BRYANSFM/Bryan_Fernandez_ELECTIVA_2025_C2/Fuentes de Informacion  para la placa.pdf

Paginas en donde indague sobre:
Esquemas electrónicos de las funcionalidades que necesitamos (RS-485 - Entradas digitales NPN PNP - Salidas y entradas 0-10 - salidas y entradas 4-20ma). https://www.wut.de/e-6wwww-11-apes-000.phphttps://www.sinsmarts.com/es/blog/rs232-or-rs485-comparing-the-key-differences/https://maplesystems.com/faq/what-is-the-dif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 (https://www.reddit.com/r/PLC/comments/71lqb3/i_understand_the_difference_between_pnp_and_npn/)
https://www.balluff.com/en-us/blog/analog-signals-0-to-10-v-vs-4-to-20-ma
