BRYANSFM/Bryan_Fernandez_ELECTIVA_2025_C2/Garabato, PCB.pdf

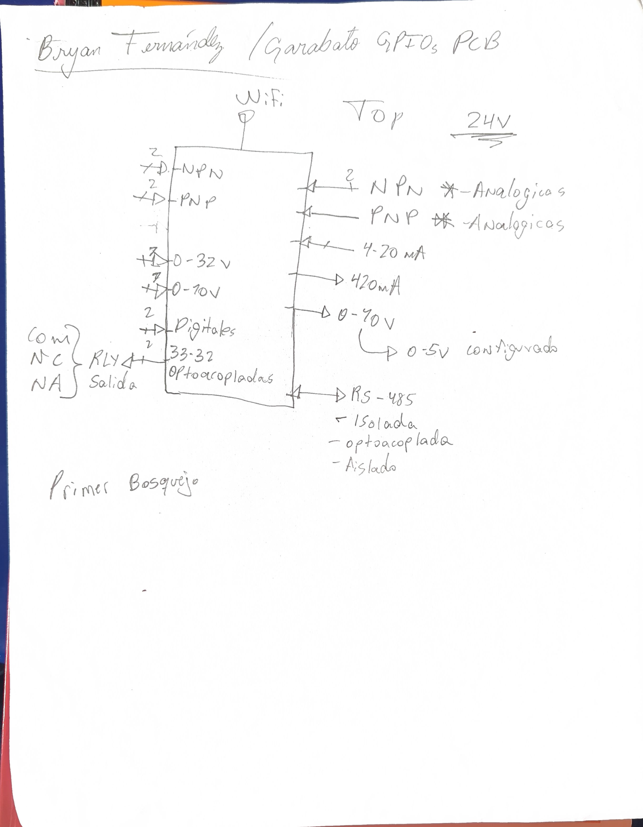
[picture p1: page 1]
