BRYANSFM/Bryan_Fernandez_ELECTIVA_2025_C2/Caja_para_PCB(FreeCAD)/Caja_para_PCB(FreeCAD)/Caja_Parte_de_Arriba_Electiva.FCStd

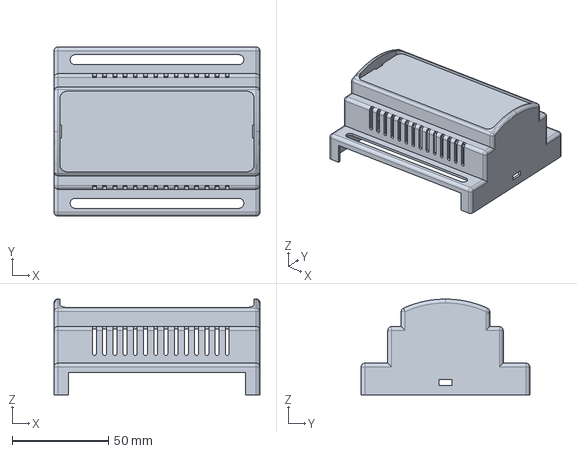
[picture p2: CAD file, 2025-07-17]
Caja_para_PCB(FreeCAD)/Caja_para_PCB(FreeCAD)/Caja_Parte_de_Arriba_Electiva.FCStd
107.0 x 87.7 x 49.8 mm
