BRYANSFM/Bryan_Fernandez_ELECTIVA_2025_C2/Huella YLPTEC RSM3485ECHT C2992406.DXF

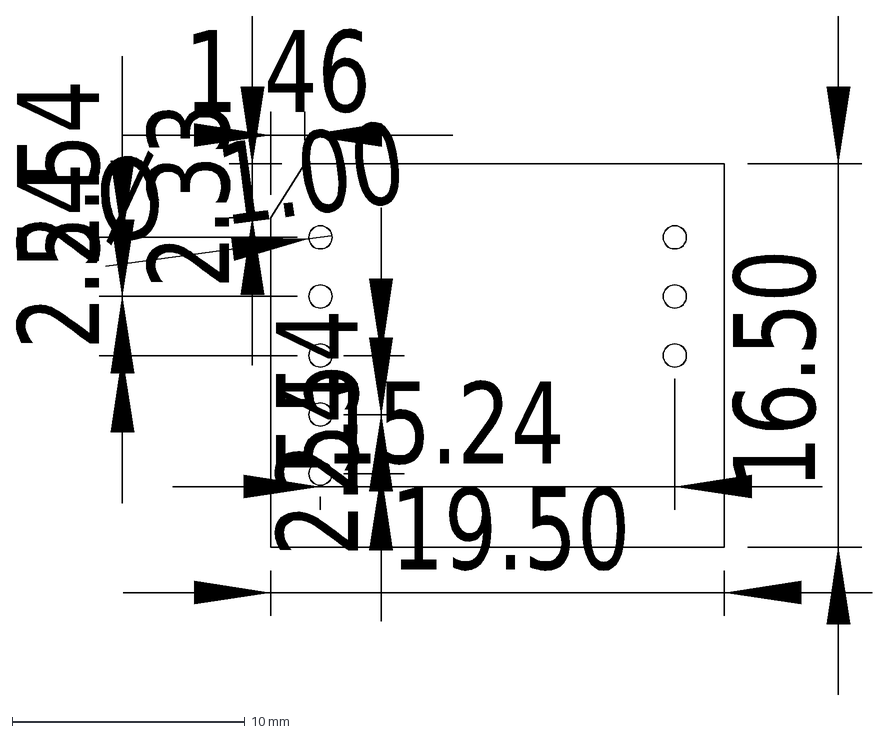
[picture p3: CAD file, 2025-07-16]
Huella YLPTEC RSM3485ECHT C2992406.DXF
16.50
15.24
2.54
Ø
1.00
19.50
1.46
2.33
