BRYANSFM/Bryan_Fernandez_ELECTIVA_2025_C2/Caja_para_PCB(FreeCAD)/Caja_para_PCB(FreeCAD)/Caja_Electiva.FCStd

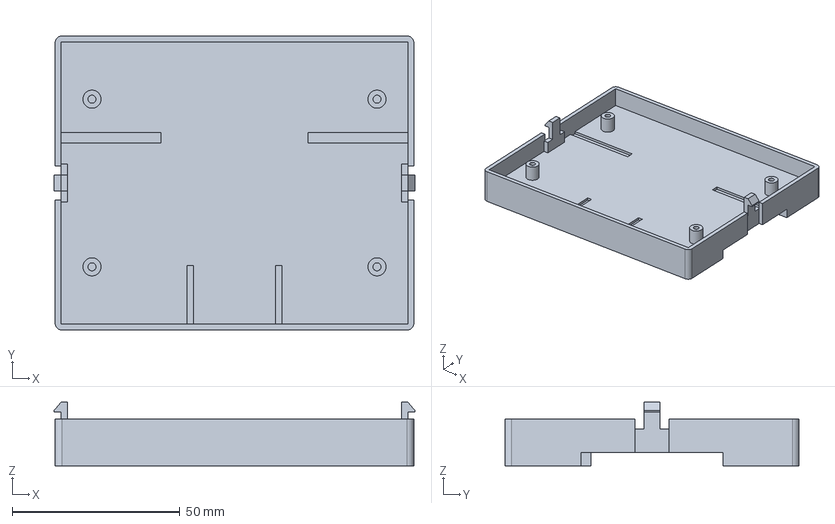
[picture p4: CAD file, 2025-07-11]
Caja_para_PCB(FreeCAD)/Caja_para_PCB(FreeCAD)/Caja_Electiva.FCStd
107.7 x 87.7 x 19.0 mm
