BRYANSFM/Bryan_Fernandez_ELECTIVA_2025_C2/Caja_Parte_de_Arriba_Electiva.dxf

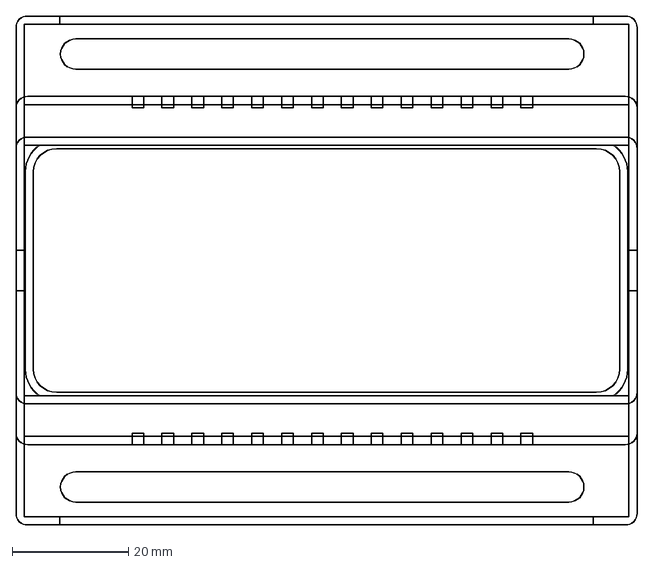
[picture p5: CAD file, 2025-07-11]
Caja_Parte_de_Arriba_Electiva.dxf
107.0 x 87.7 mm
