BRYANSFM/Bryan_Fernandez_ELECTIVA_2025_C2/CajaElectiva_para_PCB.dxf

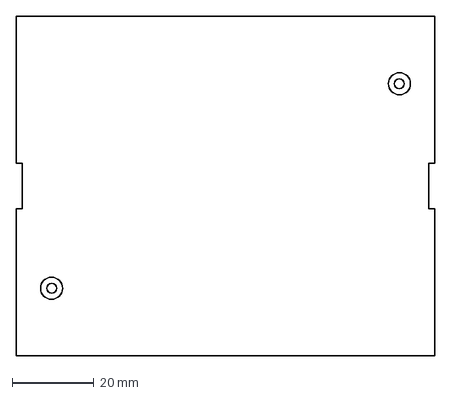
[picture p6: CAD file, 2025-07-11]
CajaElectiva_para_PCB.dxf
102.2 x 83.0 mm
