BRYANSFM/Bryan_Fernandez_ELECTIVA_2025_C2/zorionx_nivara/zorionx_nivara.kicad_pcb

## KiCad design zorionx_nivara/zorionx_nivara.kicad_pcb (2025-08-22)

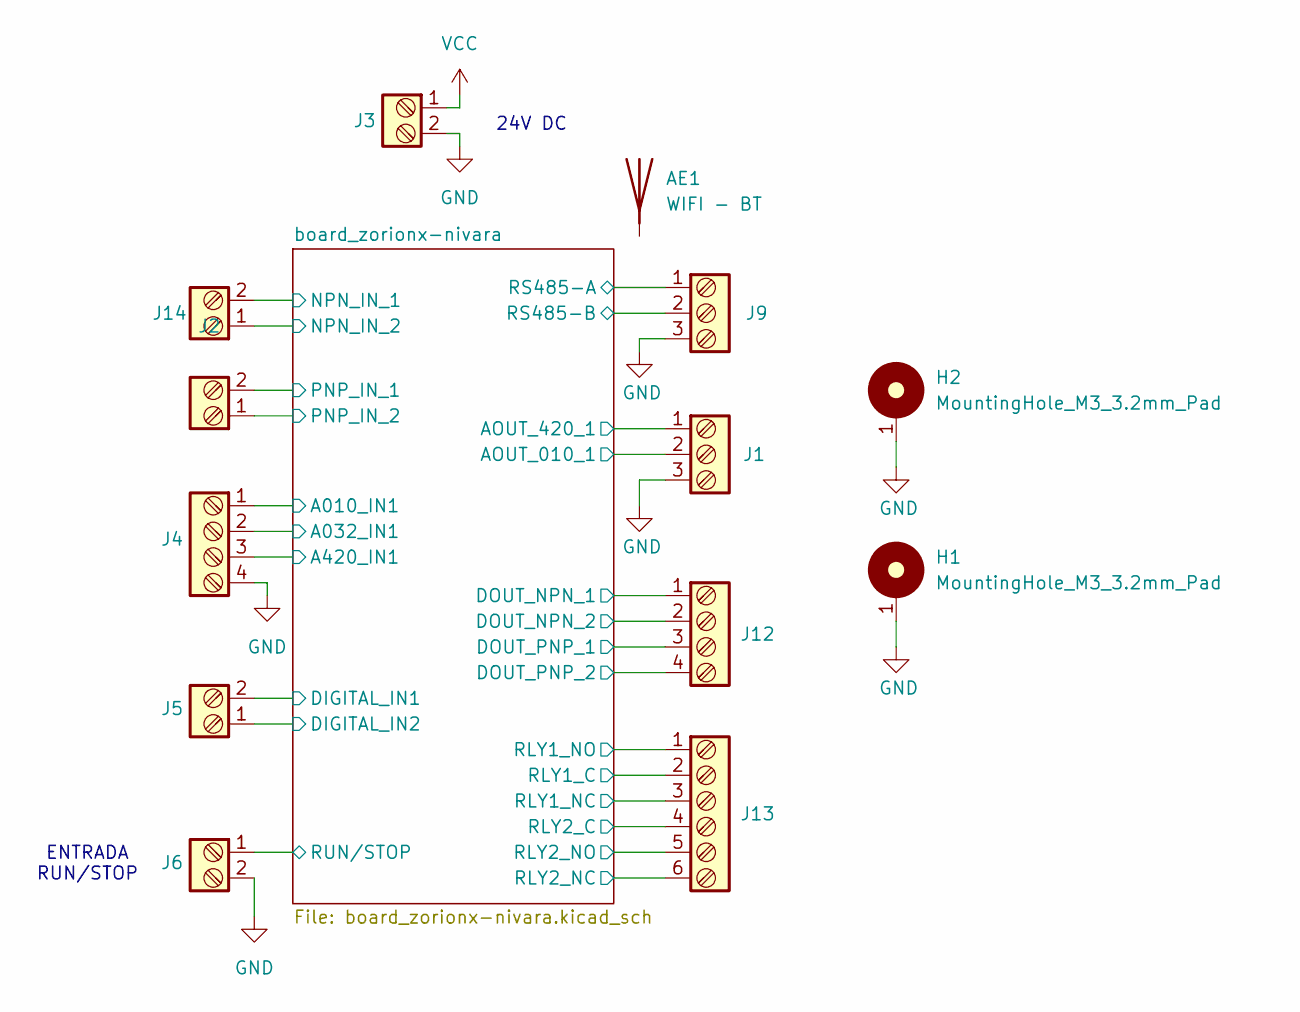
[picture p7: schematic zorionx_nivara.kicad_sch, ZorionX - Nivara / Bryan S. Fernandez M. 2022-0917]

Parts:
AE1: WIFI - BT
H1, H2: MountingHole_M3_3.2mm_Pad; MountingHole_3.2mm_Pad
J1: Salidas Analogicas; TerminalBlock_Phoenix_PT-1,5-3-5.0-H_1x03_P5.00mm_Horizontal
J2: Entrada PNP; TerminalBlock_Phoenix_PT-1,5-2-5.0-H_1x02_P5.00mm_Horizontal
J3: Alimentacion; TerminalBlock_Phoenix_PT-1,5-2-5.0-H_1x02_P5.00mm_Horizontal
J4: Entradas Analogicas; TerminalBlock_Phoenix_PT-1,5-4-5.0-H_1x04_P5.00mm_Horizontal
J5: Entradas digitales; TerminalBlock_Phoenix_PT-1,5-2-5.0-H_1x02_P5.00mm_Horizontal
J6: RUN/STOP; TerminalBlock_Phoenix_PT-1,5-2-5.0-H_1x02_P5.00mm_Horizontal
J9: RS-485; TerminalBlock_Phoenix_PT-1,5-3-5.0-H_1x03_P5.00mm_Horizontal
J12: Salidas NPN/PNP; TerminalBlock_Phoenix_PT-1,5-4-5.0-H_1x04_P5.00mm_Horizontal
J13: Reles; TerminalBlock_Phoenix_PT-1,5-6-5.0-H_1x06_P5.00mm_Horizontal
J14: Entrada NPN; TerminalBlock_Phoenix_PT-1,5-2-5.0-H_1x02_P5.00mm_Horizontal

Connections:
/board_zorionx-nivara/A010_IN1: J4.1; also elsewhere on the board
/board_zorionx-nivara/A032_IN1: J4.2; also elsewhere on the board
/board_zorionx-nivara/A420_IN1: J4.3; also elsewhere on the board
/board_zorionx-nivara/AOUT_010_1: J1.2; also elsewhere on the board
/board_zorionx-nivara/AOUT_420_1: J1.1; also elsewhere on the board
/board_zorionx-nivara/DIGITAL_IN1: J5.2; also elsewhere on the board
/board_zorionx-nivara/DIGITAL_IN2: J5.1; also elsewhere on the board
/board_zorionx-nivara/DOUT_NPN_1: J12.1; also elsewhere on the board
/board_zorionx-nivara/DOUT_NPN_2: J12.2; also elsewhere on the board
/board_zorionx-nivara/DOUT_PNP_1: J12.3; also elsewhere on the board
/board_zorionx-nivara/DOUT_PNP_2: J12.4; also elsewhere on the board
/board_zorionx-nivara/NPN_IN_1: J14.2; also elsewhere on the board
/board_zorionx-nivara/NPN_IN_2: J14.1; also elsewhere on the board
/board_zorionx-nivara/PNP_IN_1: J2.2; also elsewhere on the board
/board_zorionx-nivara/PNP_IN_2: J2.1; also elsewhere on the board
/board_zorionx-nivara/RLY1_C: J13.2; also elsewhere on the board
/board_zorionx-nivara/RLY1_NC: J13.3; also elsewhere on the board
/board_zorionx-nivara/RLY1_NO: J13.1; also elsewhere on the board
/board_zorionx-nivara/RLY2_C: J13.4; also elsewhere on the board
/board_zorionx-nivara/RLY2_NC: J13.6; also elsewhere on the board
/board_zorionx-nivara/RLY2_NO: J13.5; also elsewhere on the board
/board_zorionx-nivara/RS485-A: J9.1; also elsewhere on the board
/board_zorionx-nivara/RS485-B: J9.2; also elsewhere on the board
/board_zorionx-nivara/RUN/STOP: J6.1; also elsewhere on the board
GND: H1.1, H2.1, J1.3, J3.2, J4.4, J6.2, J9.3; also elsewhere on the board
VCC: J3.1; also elsewhere on the board

Notes on the sheet:
ENTRADA RUN/STOP
24V DC

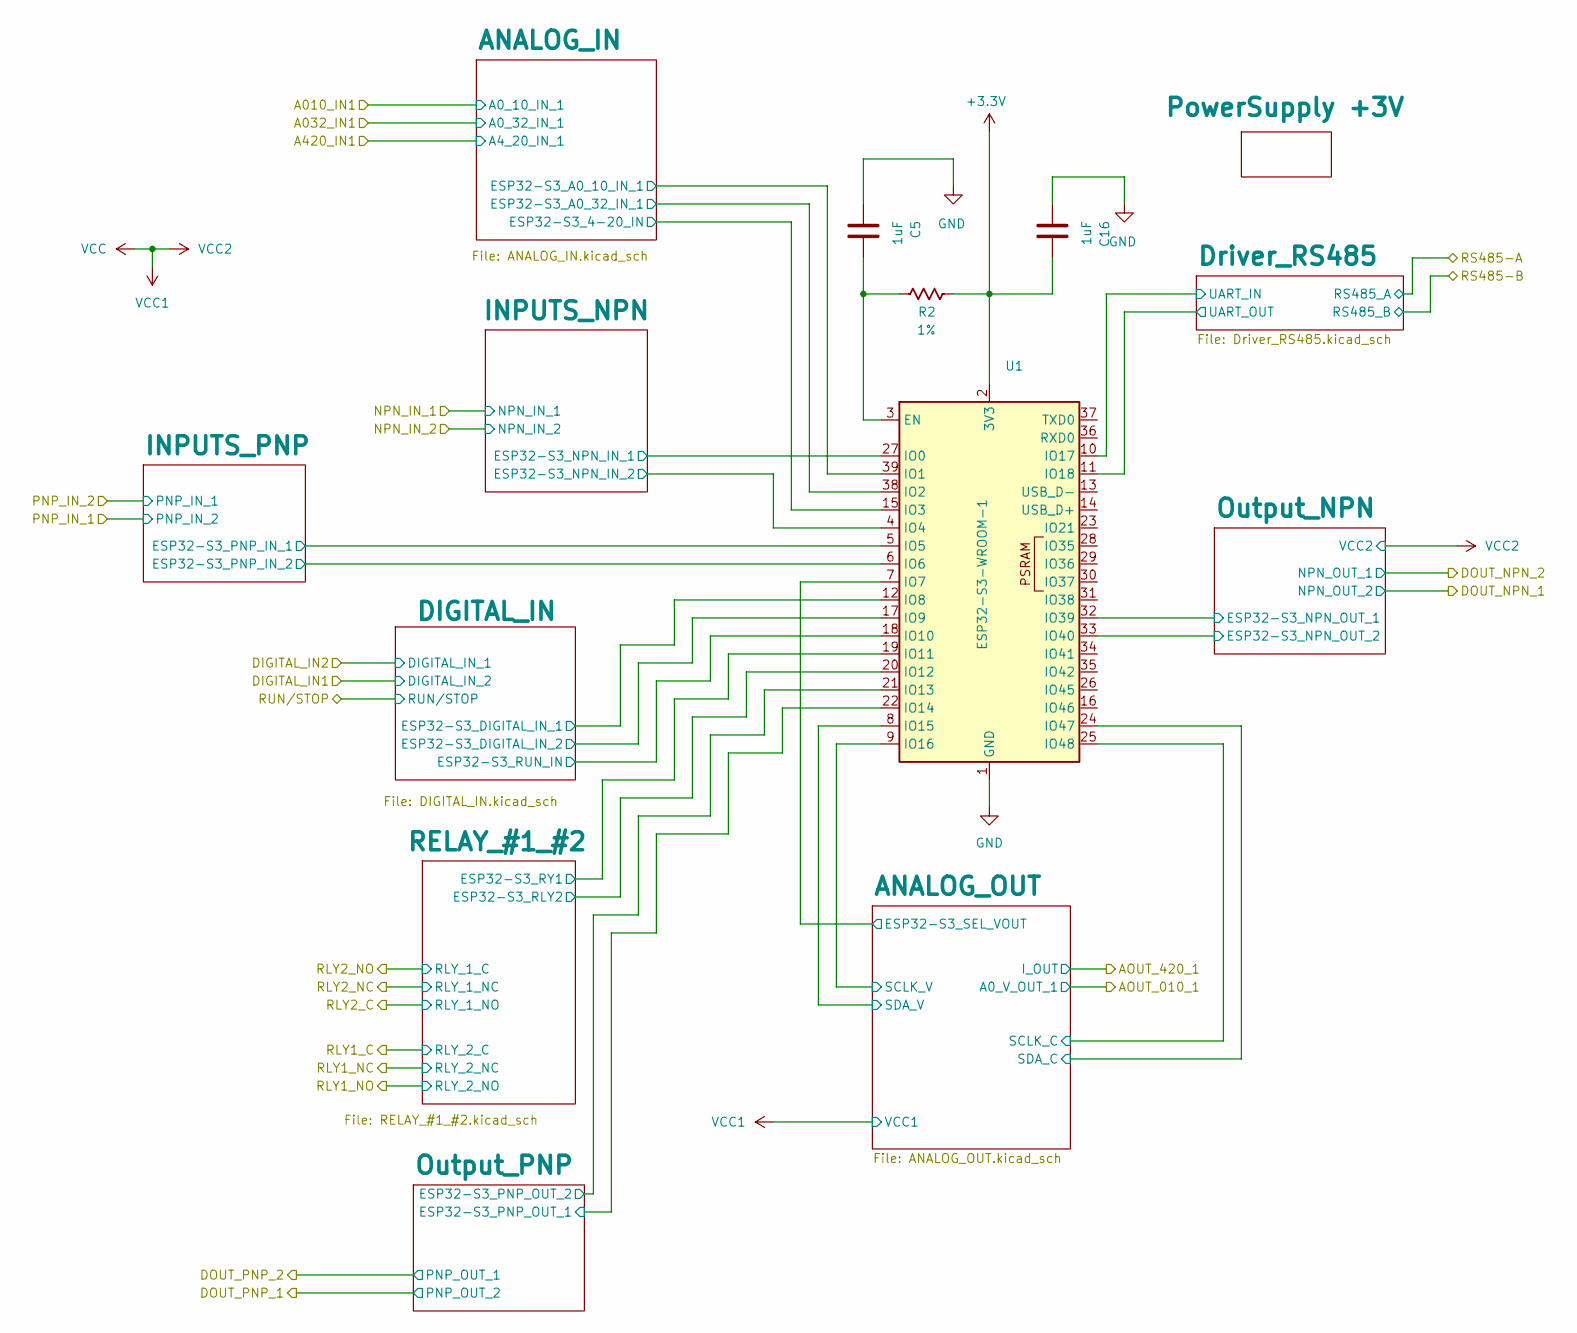
[picture p8: schematic board_zorionx-nivara.kicad_sch]

Parts:
C5, C16: 1uF; C_0603_1608Metric
R2: R_0603_1608Metric; Tolerancia 1%
U1: ESP32-S3-WROOM-1

Connections:
+3.3V: C16.1, R2.1, U1.2 (3V3); also elsewhere on the board
/board_zorionx-nivara/ANALOG_IN/ESP32-S3_4-20_IN: U1.15 (IO3); also elsewhere on the board
/board_zorionx-nivara/ANALOG_IN/ESP32-S3_A0_10_IN_1: U1.39 (IO1); also elsewhere on the board
/board_zorionx-nivara/ANALOG_IN/ESP32-S3_A0_32_IN_1: U1.38 (IO2); also elsewhere on the board
/board_zorionx-nivara/ANALOG_OUT/ESP32-S3_SEL_VOUT: U1.7 (IO7); also elsewhere on the board
/board_zorionx-nivara/ANALOG_OUT/SCLK_C: U1.25 (IO48); also elsewhere on the board
/board_zorionx-nivara/ANALOG_OUT/SCLK_V: U1.9 (IO16); also elsewhere on the board
/board_zorionx-nivara/ANALOG_OUT/SDA_C: U1.24 (IO47); also elsewhere on the board
/board_zorionx-nivara/ANALOG_OUT/SDA_V: U1.8 (IO15); also elsewhere on the board
/board_zorionx-nivara/DIGITAL_IN/ESP32-S3_DIGITAL_IN_1: U1.12 (IO8); also elsewhere on the board
/board_zorionx-nivara/DIGITAL_IN/ESP32-S3_DIGITAL_IN_2: U1.17 (IO9); also elsewhere on the board
/board_zorionx-nivara/DIGITAL_IN/ESP32-S3_RUN_IN: U1.18 (IO10); also elsewhere on the board
/board_zorionx-nivara/Driver_RS485/UART_IN: U1.10 (IO17); also elsewhere on the board
/board_zorionx-nivara/Driver_RS485/UART_OUT: U1.11 (IO18); also elsewhere on the board
/board_zorionx-nivara/INPUTS_NPN/ESP32-S3_NPN_IN_1: U1.27 (IO0); also elsewhere on the board
/board_zorionx-nivara/INPUTS_NPN/ESP32-S3_NPN_IN_2: U1.4 (IO4); also elsewhere on the board
/board_zorionx-nivara/INPUTS_PNP/ESP32-S3_PNP_IN_1: U1.5 (IO5); also elsewhere on the board
/board_zorionx-nivara/INPUTS_PNP/ESP32-S3_PNP_IN_2: U1.6 (IO6); also elsewhere on the board
/board_zorionx-nivara/Output_NPN/ESP32-S3_NPN_OUT_1: U1.32 (IO39); also elsewhere on the board
/board_zorionx-nivara/Output_NPN/ESP32-S3_NPN_OUT_2: U1.33 (IO40); also elsewhere on the board
/board_zorionx-nivara/Output_PNP/ESP32-S3_PNP_OUT_1: U1.22 (IO14); also elsewhere on the board
/board_zorionx-nivara/Output_PNP/ESP32-S3_PNP_OUT_2: U1.21 (IO13); also elsewhere on the board
/board_zorionx-nivara/RELAY_#1_#2/ESP32-S3_RLY2: U1.20 (IO12); also elsewhere on the board
/board_zorionx-nivara/RELAY_#1_#2/ESP32-S3_RY1: U1.19 (IO11); also elsewhere on the board
GND: C5.2, C16.2, U1.1 (GND), U1.40 (GND), U1.41 (GND); also elsewhere on the board
unnamed: C5.1, R2.2, U1.3 (EN)

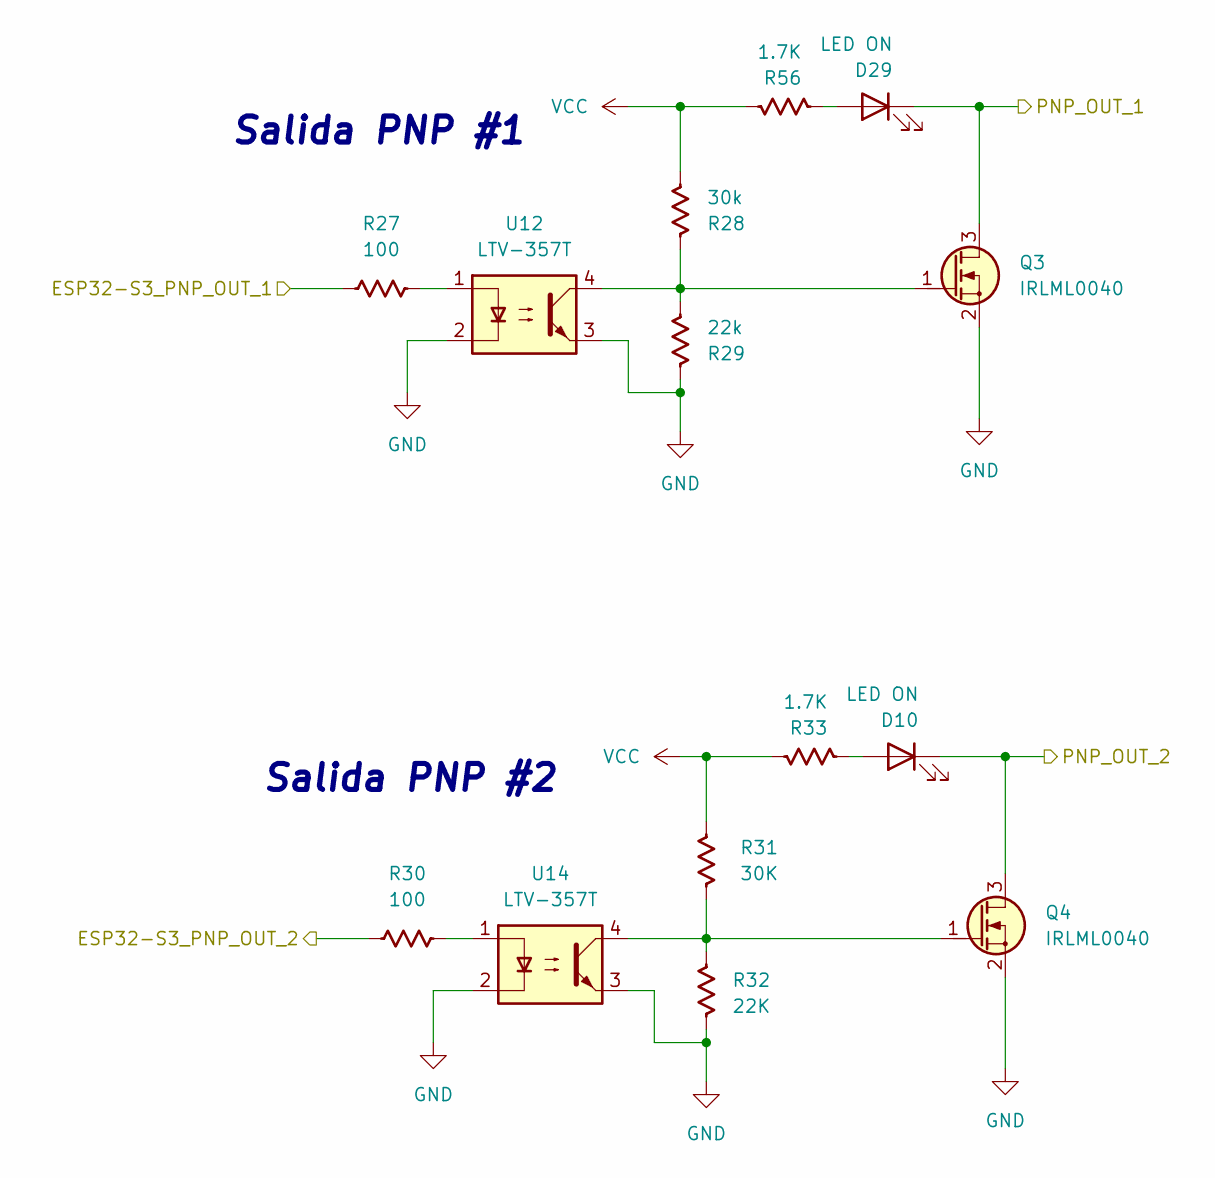
[picture p9: schematic Output_PNP.kicad_sch]

Parts:
D10, D29: LED ON; LED_0603_1608Metric
Q3, Q4: IRLML0040; SOT-23
R27, R30: 100; R_0603_1608Metric
R28: 30k; R_0603_1608Metric
R29: 22k; R_0603_1608Metric
R31: 30K; R_0603_1608Metric
R32: 22K; R_0603_1608Metric
R33, R56: 1.7K; R_0603_1608Metric
U12, U14: LTV-357T; SO-4_4.4x3.6mm_P2.54mm

Connections:
/board_zorionx-nivara/DOUT_PNP_1: D10.1 (K), Q4.3 (D); also elsewhere on the board
/board_zorionx-nivara/DOUT_PNP_2: D29.1 (K), Q3.3 (D); also elsewhere on the board
/board_zorionx-nivara/Output_PNP/ESP32-S3_PNP_OUT_1: R27.1; also elsewhere on the board
/board_zorionx-nivara/Output_PNP/ESP32-S3_PNP_OUT_2: R30.1; also elsewhere on the board
GND: Q3.2 (S), Q4.2 (S), R29.1, R32.1, U12.2, U12.3, U14.2, U14.3; also elsewhere on the board
unnamed: D10.2 (A), R33.2
unnamed: D29.2 (A), R56.2
unnamed: Q3.1 (G), R28.1, R29.2, U12.4
unnamed: Q4.1 (G), R31.1, R32.2, U14.4
unnamed: R27.2, U12.1
unnamed: R30.2, U14.1
VCC: R28.2, R31.2, R33.1, R56.1; also elsewhere on the board

Notes on the sheet:
Salida PNP #1
Salida PNP #2

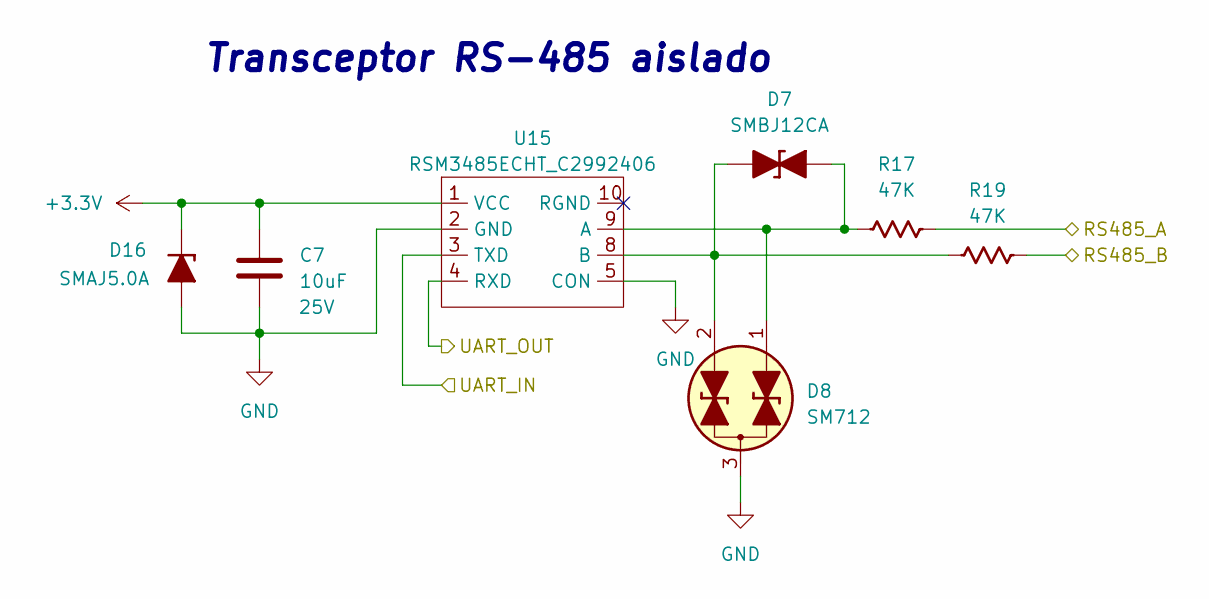
[picture p10: schematic Driver_RS485.kicad_sch]

Parts:
C7: 10uF; C_0603_1608Metric
D7: SMBJ12CA; D_SMB_TVS
D8: SM712; SOT-23
D16: SMAJ5.0A; D_SMA
R17, R19: 47K; R_0603_1608Metric
U15: RSM3485ECHT_C2992406; YLPTEC RSM3485ECHT

Connections:
+3.3V: C7.1, D16.1 (K), U15.1 (VCC); also elsewhere on the board
/board_zorionx-nivara/Driver_RS485/UART_IN: U15.3 (TXD); also elsewhere on the board
/board_zorionx-nivara/Driver_RS485/UART_OUT: U15.4 (RXD); also elsewhere on the board
/board_zorionx-nivara/RS485-A: R17.2; also elsewhere on the board
/board_zorionx-nivara/RS485-B: R19.2; also elsewhere on the board
GND: C7.2, D8.3 (Com), D16.2 (A), U15.2 (GND), U15.5 (CON); also elsewhere on the board
unnamed: D7.2 (A), D8.1 (A1), R17.1, U15.9 (A)
unnamed: D7.1 (K), D8.2 (A2), R19.1, U15.8 (B)

Notes on the sheet:
Transceptor RS-485 aislado

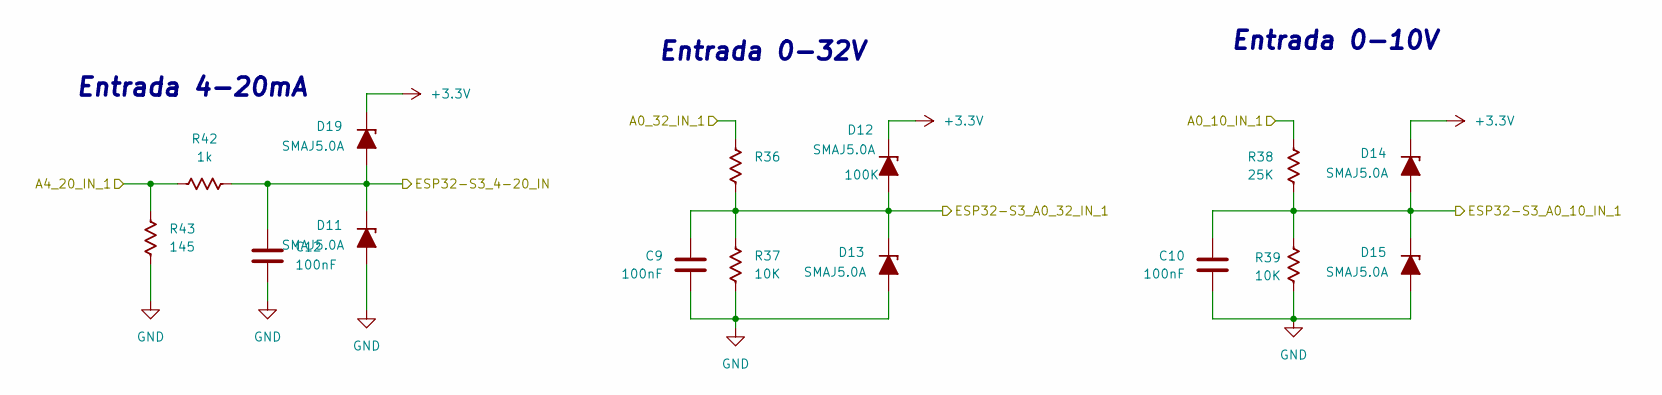
[picture p11: schematic ANALOG_IN.kicad_sch]

Parts:
C9, C10, C12: 100nF; C_0603_1608Metric; Voltage 10V
D11, D12, D13, D14, D15, D19: SMAJ5.0A; D_SMA
R36: 100K; R_0603_1608Metric
R37, R39: 10K; R_0603_1608Metric
R38: 25K; R_0603_1608Metric
R42: 1k; R_0603_1608Metric
R43: 145; R_0805_2012Metric

Connections:
+3.3V: D12.1 (K), D14.1 (K), D19.1 (K); also elsewhere on the board
/board_zorionx-nivara/A010_IN1: R38.2; also elsewhere on the board
/board_zorionx-nivara/A032_IN1: R36.2; also elsewhere on the board
/board_zorionx-nivara/A420_IN1: R42.1, R43.1; also elsewhere on the board
/board_zorionx-nivara/ANALOG_IN/ESP32-S3_4-20_IN: C12.1, D11.1 (K), D19.2 (A), R42.2; also elsewhere on the board
/board_zorionx-nivara/ANALOG_IN/ESP32-S3_A0_10_IN_1: C10.1, D14.2 (A), D15.1 (K), R38.1, R39.2; also elsewhere on the board
/board_zorionx-nivara/ANALOG_IN/ESP32-S3_A0_32_IN_1: C9.1, D12.2 (A), D13.1 (K), R36.1, R37.2; also elsewhere on the board
GND: C9.2, C10.2, C12.2, D11.2 (A), D13.2 (A), D15.2 (A), R37.1, R39.1, R43.2; also elsewhere on the board

Notes on the sheet:
Entrada 0-10V
Entrada 0-32V
Entrada 4-20mA

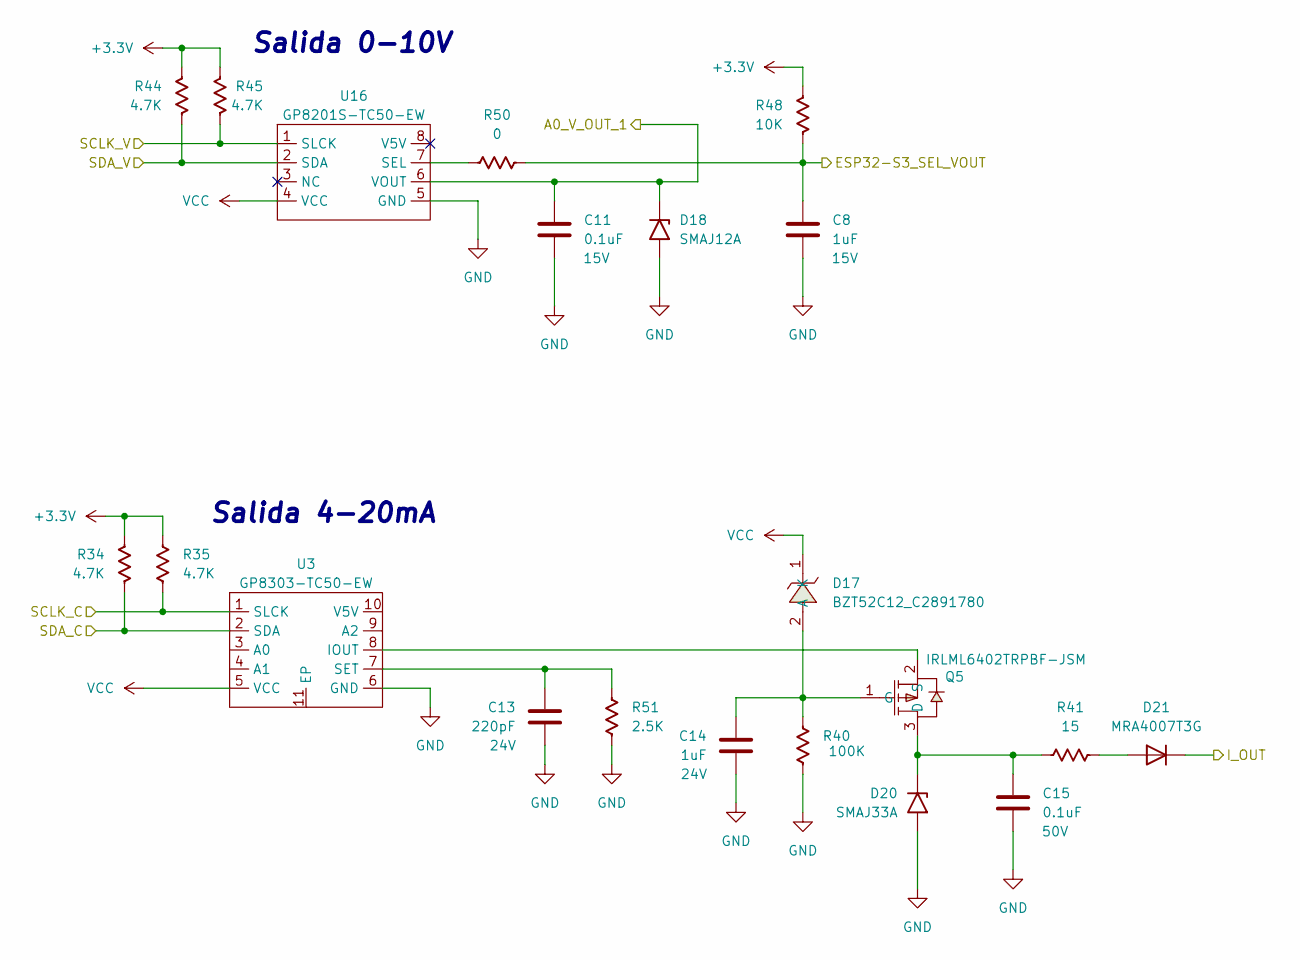
[picture p12: schematic ANALOG_OUT.kicad_sch]

Parts:
C8, C14: 1uF; C_0603_1608Metric
C11, C15: 0.1uF; C_0603_1608Metric
C13: 220pF; C_0603_1608Metric
D17: BZT52C12_C2891780; D_SOD-123; LCSC Part C2891780
D18: SMAJ12A; D_SMA
D20: SMAJ33A; D_SMA
D21: MRA4007T3G; D_SMA
Q5: IRLML6402TRPBF-JSM; SOT-23; LCSC Part C18190991
R34, R35, R44, R45: 4.7K; R_0603_1608Metric
R40: 100K; R_0603_1608Metric
R41: 15; R_0805_2012Metric
R48: 10K; R_0603_1608Metric
R50: 0; R_0603_1608Metric
R51: 2.5K; R_0603_1608Metric
U3: GP8303-TC50-EW; SSOP-10_3.9x4.9mm_P1.00mm
U16: GP8201S-TC50-EW; SSOP-8_3.95x5.21x3.27mm_P1.27mm

Connections:
+3.3V: R34.1, R35.1, R44.1, R45.1, R48.1; also elsewhere on the board
/board_zorionx-nivara/ANALOG_OUT/ESP32-S3_SEL_VOUT: C8.1, R48.2, R50.2; also elsewhere on the board
/board_zorionx-nivara/ANALOG_OUT/SCLK_C: R35.2, U3.1 (SLCK); also elsewhere on the board
/board_zorionx-nivara/ANALOG_OUT/SCLK_V: R45.2, U16.1 (SLCK); also elsewhere on the board
/board_zorionx-nivara/ANALOG_OUT/SDA_C: R34.2, U3.2 (SDA); also elsewhere on the board
/board_zorionx-nivara/ANALOG_OUT/SDA_V: R44.2, U16.2 (SDA); also elsewhere on the board
/board_zorionx-nivara/AOUT_010_1: C11.1, D18.1 (A1), U16.6 (VOUT); also elsewhere on the board
/board_zorionx-nivara/AOUT_420_1: D21.1 (K); also elsewhere on the board
GND: C8.2, C11.2, C13.2, C14.2, C15.2, D18.2 (A2), D20.2 (A2), R40.2, R51.2, U3.6 (GND), U16.5 (GND); also elsewhere on the board
unnamed: C14.1, D17.2 (A), Q5.1 (G), R40.1
unnamed: C15.1, D20.1 (A1), Q5.3 (D), R41.1
unnamed: D21.2 (A), R41.2
unnamed: Q5.2 (S), U3.8 (IOUT)
unnamed: C13.1, R51.1, U3.7 (SET)
unnamed: R50.1, U16.7 (SEL)
VCC: D17.1 (K), U3.5 (VCC), U16.4 (VCC); also elsewhere on the board

Notes on the sheet:
Salida 0-10V
Salida 4-20mA

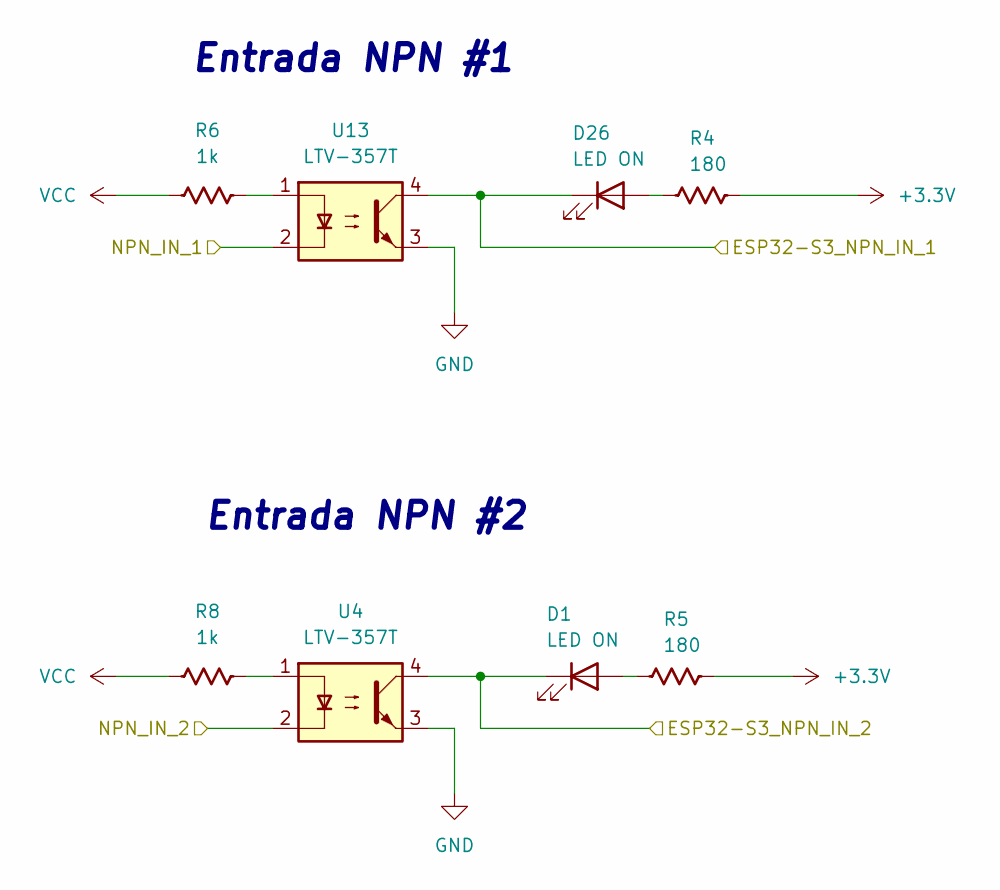
[picture p13: schematic Input_NPN.kicad_sch]

Parts:
D1, D26: LED ON; LED_0603_1608Metric
R4, R5: 180; R_0603_1608Metric
R6, R8: 1k; R_0603_1608Metric
U4, U13: LTV-357T; SO-4_4.4x3.6mm_P2.54mm

Connections:
+3.3V: R4.1, R5.1; also elsewhere on the board
/board_zorionx-nivara/INPUTS_NPN/ESP32-S3_NPN_IN_1: D26.1 (K), U13.4; also elsewhere on the board
/board_zorionx-nivara/INPUTS_NPN/ESP32-S3_NPN_IN_2: D1.1 (K), U4.4; also elsewhere on the board
/board_zorionx-nivara/NPN_IN_1: U13.2; also elsewhere on the board
/board_zorionx-nivara/NPN_IN_2: U4.2; also elsewhere on the board
GND: U4.3, U13.3; also elsewhere on the board
unnamed: D1.2 (A), R5.2
unnamed: D26.2 (A), R4.2
unnamed: R6.2, U13.1
unnamed: R8.2, U4.1
VCC: R6.1, R8.1; also elsewhere on the board

Notes on the sheet:
Entrada NPN #2
Entrada NPN #1

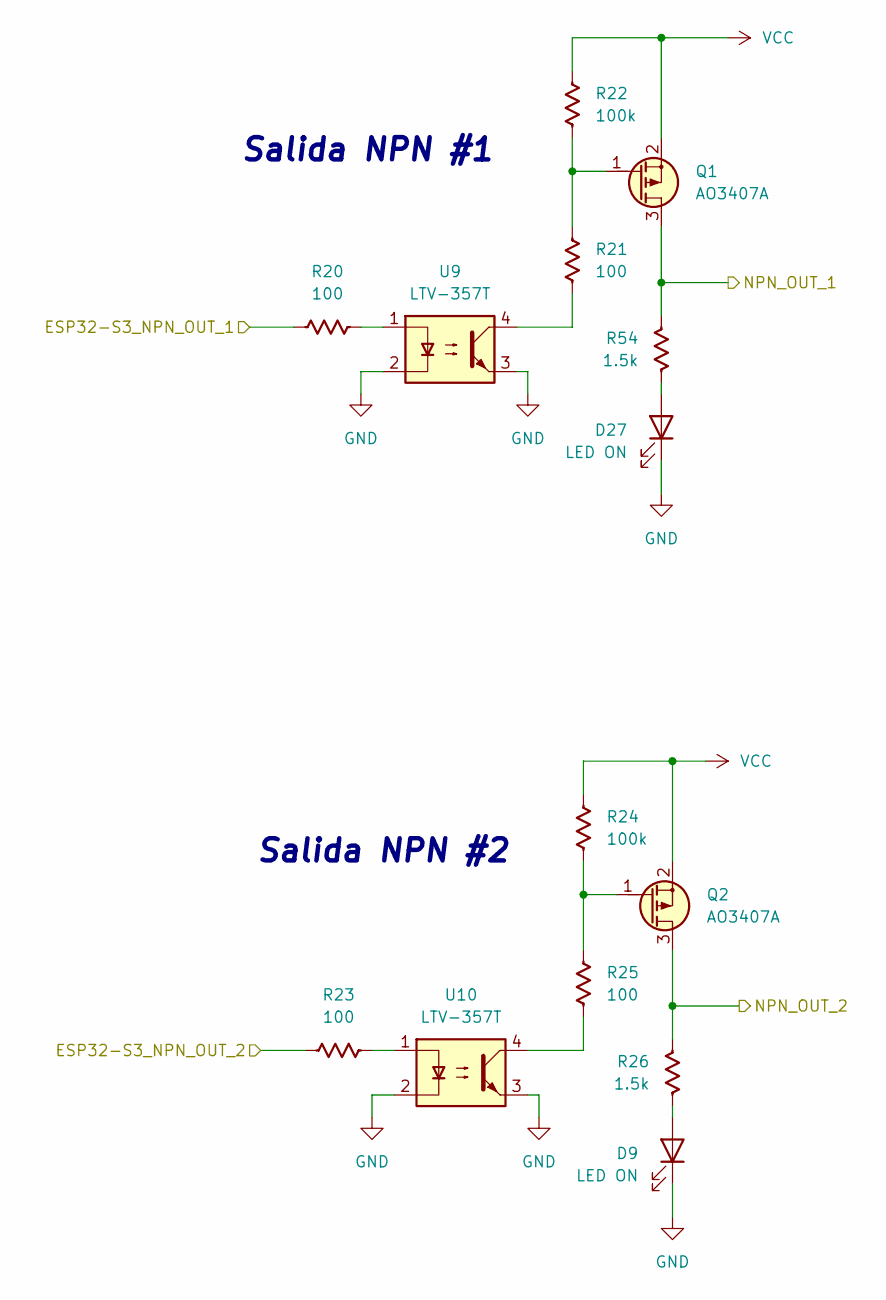
[picture p14: schematic Output_NPN.kicad_sch]

Parts:
D9, D27: LED ON; LED_0603_1608Metric
Q1, Q2: AO3407A; SOT-23
R20, R21, R23, R25: 100; R_0603_1608Metric
R22, R24: 100k; R_0603_1608Metric
R26, R54: 1.5k; R_0603_1608Metric
U9, U10: LTV-357T; SO-4_4.4x3.6mm_P2.54mm

Connections:
/board_zorionx-nivara/DOUT_NPN_1: Q2.3 (D), R26.1; also elsewhere on the board
/board_zorionx-nivara/DOUT_NPN_2: Q1.3 (D), R54.1; also elsewhere on the board
/board_zorionx-nivara/Output_NPN/ESP32-S3_NPN_OUT_1: R20.1; also elsewhere on the board
/board_zorionx-nivara/Output_NPN/ESP32-S3_NPN_OUT_2: R23.1; also elsewhere on the board
GND: D9.1 (K), D27.1 (K), U9.2, U9.3, U10.2, U10.3; also elsewhere on the board
unnamed: D9.2 (A), R26.2
unnamed: D27.2 (A), R54.2
unnamed: Q1.1 (G), R21.1, R22.2
unnamed: Q2.1 (G), R24.2, R25.1
unnamed: R20.2, U9.1
unnamed: R21.2, U9.4
unnamed: R23.2, U10.1
unnamed: R25.2, U10.4
VCC: Q1.2 (S), Q2.2 (S), R22.1, R24.1; also elsewhere on the board

Notes on the sheet:
Salida NPN #1
Salida NPN #2

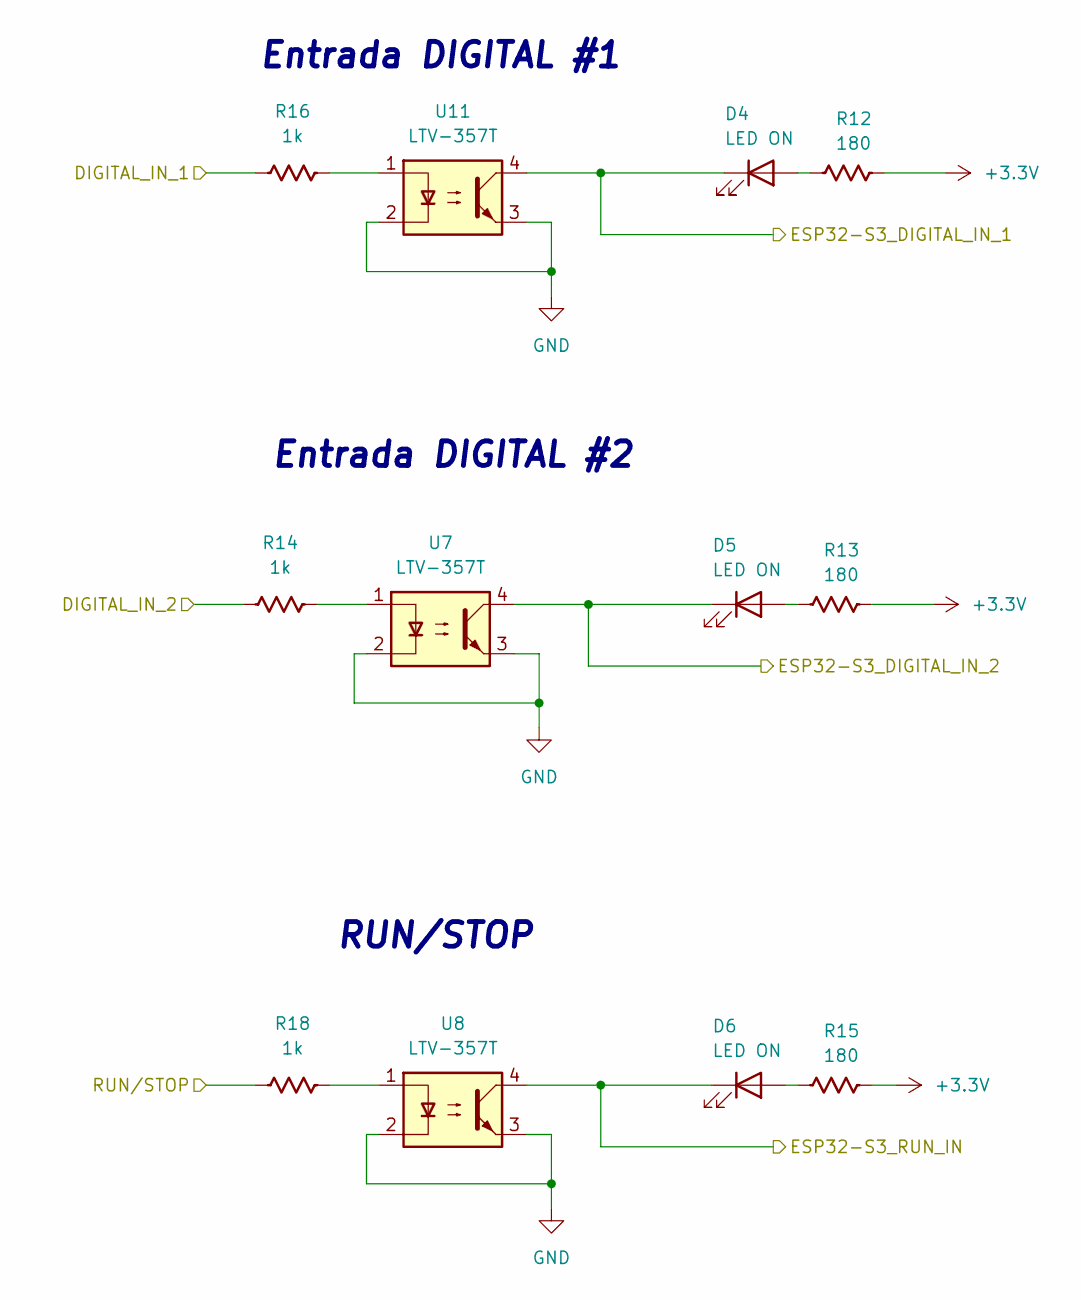
[picture p15: schematic DIGITAL_IN.kicad_sch]

Parts:
D4, D5, D6: LED ON; LED_0603_1608Metric
R12, R13, R15: 180; R_0603_1608Metric
R14, R16, R18: 1k; R_0603_1608Metric
U7, U8, U11: LTV-357T; SO-4_4.4x3.6mm_P2.54mm

Connections:
+3.3V: R12.1, R13.1, R15.1; also elsewhere on the board
/board_zorionx-nivara/DIGITAL_IN1: R14.1; also elsewhere on the board
/board_zorionx-nivara/DIGITAL_IN2: R16.1; also elsewhere on the board
/board_zorionx-nivara/DIGITAL_IN/ESP32-S3_DIGITAL_IN_1: D4.1 (K), U11.4; also elsewhere on the board
/board_zorionx-nivara/DIGITAL_IN/ESP32-S3_DIGITAL_IN_2: D5.1 (K), U7.4; also elsewhere on the board
/board_zorionx-nivara/DIGITAL_IN/ESP32-S3_RUN_IN: D6.1 (K), U8.4; also elsewhere on the board
/board_zorionx-nivara/RUN/STOP: R18.1; also elsewhere on the board
GND: U7.2, U7.3, U8.2, U8.3, U11.2, U11.3; also elsewhere on the board
unnamed: D4.2 (A), R12.2
unnamed: D5.2 (A), R13.2
unnamed: D6.2 (A), R15.2
unnamed: R14.2, U7.1
unnamed: R16.2, U11.1
unnamed: R18.2, U8.1

Notes on the sheet:
Entrada DIGITAL #1
Entrada DIGITAL #2
RUN/STOP

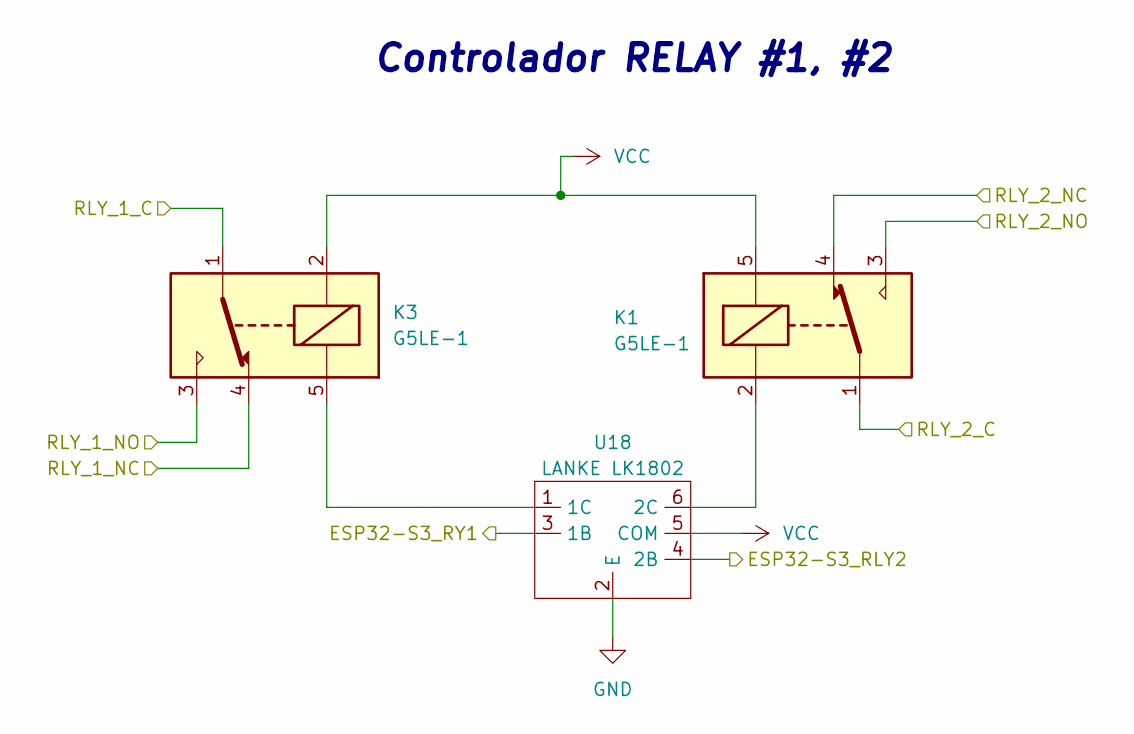
[picture p16: schematic RELAY_#1_#2.kicad_sch]

Parts:
K1, K3: G5LE-1; Relay_SPDT_Omron-G5LE-1
U18: LANKE LK1802; SOT-23-6

Connections:
/board_zorionx-nivara/RELAY_#1_#2/ESP32-S3_RLY2: U18.4 (2B); also elsewhere on the board
/board_zorionx-nivara/RELAY_#1_#2/ESP32-S3_RY1: U18.3 (1B); also elsewhere on the board
/board_zorionx-nivara/RLY1_C: K1.1; also elsewhere on the board
/board_zorionx-nivara/RLY1_NC: K1.4; also elsewhere on the board
/board_zorionx-nivara/RLY1_NO: K1.3; also elsewhere on the board
/board_zorionx-nivara/RLY2_C: K3.3; also elsewhere on the board
/board_zorionx-nivara/RLY2_NC: K3.4; also elsewhere on the board
/board_zorionx-nivara/RLY2_NO: K3.1; also elsewhere on the board
GND: U18.2 (E); also elsewhere on the board
unnamed: K3.5, U18.1 (1C)
unnamed: K1.2, U18.6 (2C)
VCC: K1.5, K3.2, U18.5 (COM); also elsewhere on the board

Notes on the sheet:
Controlador RELAY #1, #2

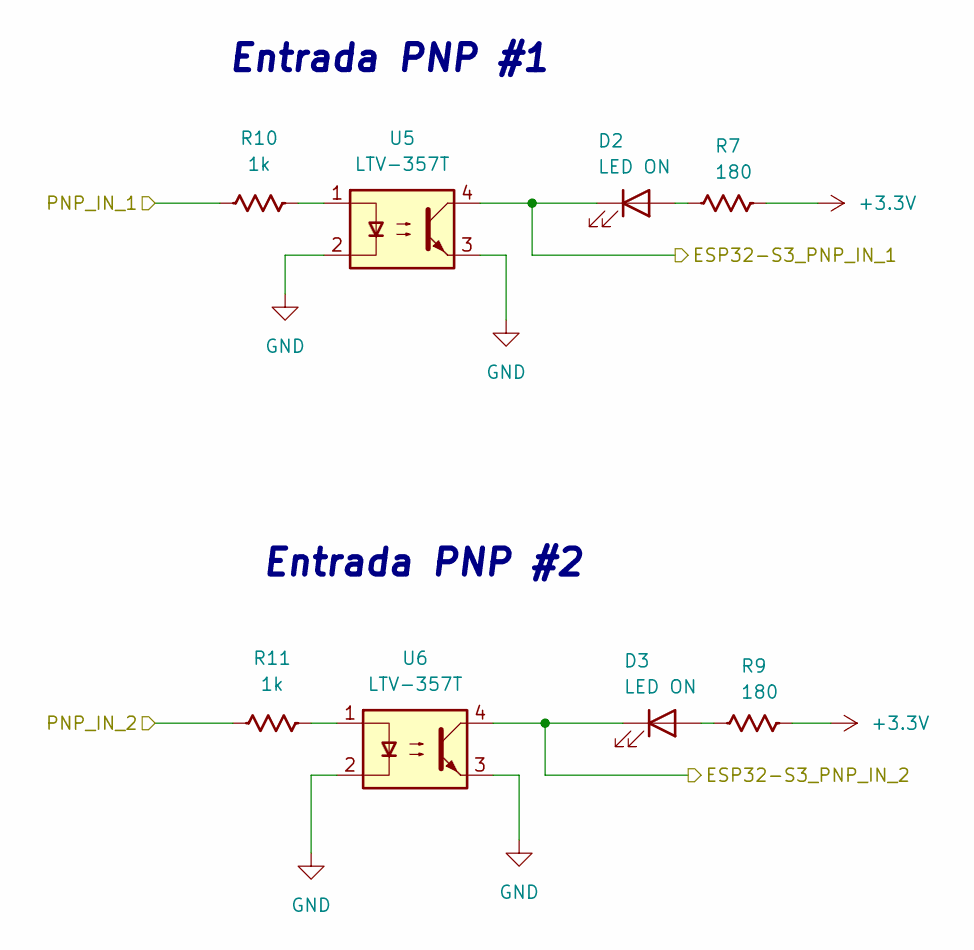
[picture p17: schematic Input_PNP.kicad_sch]

Parts:
D2, D3: LED ON; LED_0603_1608Metric
R7, R9: 180; R_0603_1608Metric
R10, R11: 1k; R_0603_1608Metric
U5, U6: LTV-357T; SO-4_4.4x3.6mm_P2.54mm

Connections:
+3.3V: R7.1, R9.1; also elsewhere on the board
/board_zorionx-nivara/INPUTS_PNP/ESP32-S3_PNP_IN_1: D2.1 (K), U5.4; also elsewhere on the board
/board_zorionx-nivara/INPUTS_PNP/ESP32-S3_PNP_IN_2: D3.1 (K), U6.4; also elsewhere on the board
/board_zorionx-nivara/PNP_IN_1: R11.1; also elsewhere on the board
/board_zorionx-nivara/PNP_IN_2: R10.1; also elsewhere on the board
GND: U5.2, U5.3, U6.2, U6.3; also elsewhere on the board
unnamed: D2.2 (A), R7.2
unnamed: D3.2 (A), R9.2
unnamed: R10.2, U5.1
unnamed: R11.2, U6.1

Notes on the sheet:
Entrada PNP #1
Entrada PNP #2

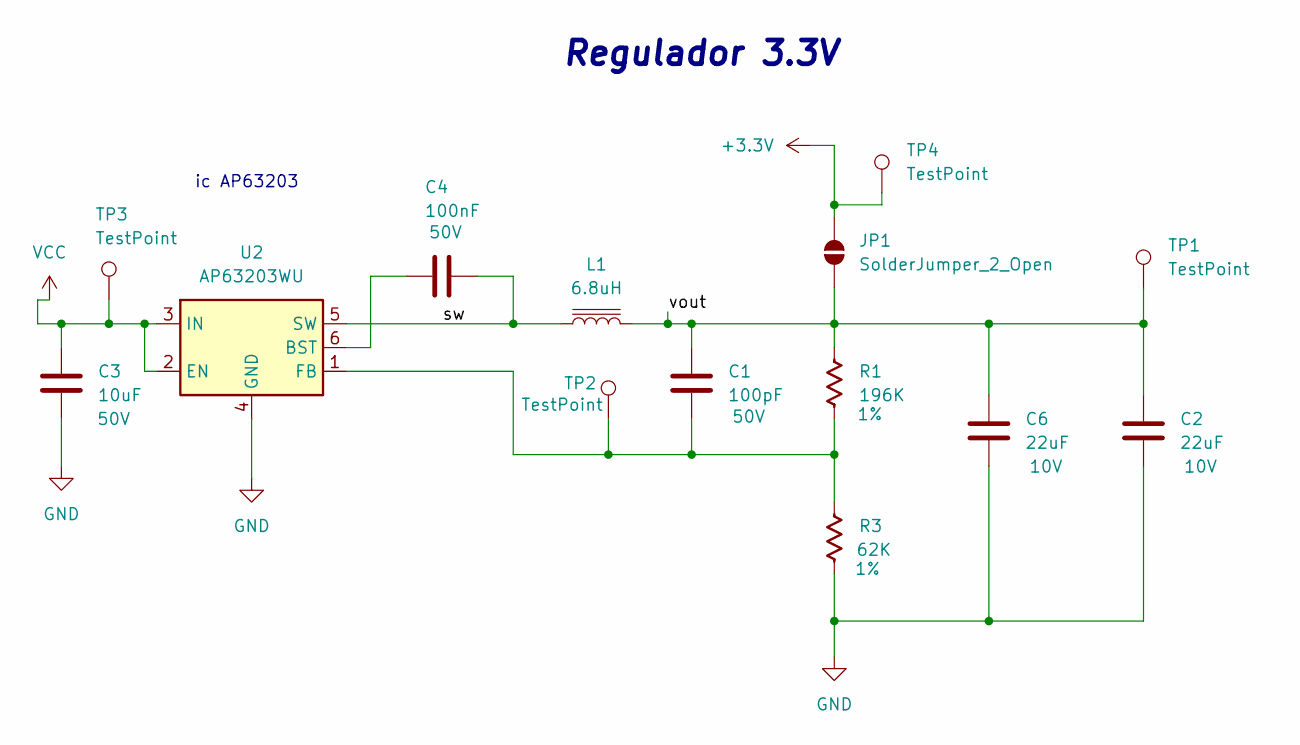
[picture p18: schematic PowerSupply.kicad_sch]

Parts:
C1: 100pF; C_0603_1608Metric
C2, C6: 22uF; C_0805
C3: 10uF; C_1206_3216Metric
C4: 100nF; C_0603_1608Metric
JP1: SolderJumper_2_Open; SolderJumper-2_P1.3mm_Open_RoundedPad1.0x1.5mm
L1: 6.8uH; L_Chilisin_BMRA00040420; Part number SL0624-6R8M
R1: 196K; R_0603_1608Metric; Tolerancia 1%
R3: 62K; R_0603_1608Metric; Tolerancia 1%
TP1, TP2, TP3, TP4: TestPoint; TestPoint_THTPad_D1.0mm_Drill0.5mm
U2: AP63203WU; TSOT-23-6

Connections:
+3.3V: JP1.2 (B), TP4.1; also elsewhere on the board
/board_zorionx-nivara/PowerSupply +3V/sw: C4.2, L1.2, U2.5 (SW)
/board_zorionx-nivara/PowerSupply +3V/vout: C1.1, C2.1, C6.1, JP1.1 (A), L1.1, R1.1, TP1.1
GND: C2.2, C3.2, C6.2, R3.2, U2.4 (GND); also elsewhere on the board
unnamed: C4.1, U2.6 (BST)
unnamed: C1.2, R1.2, R3.1, TP2.1, U2.1 (FB)
VCC: C3.1, TP3.1, U2.2 (EN), U2.3 (IN); also elsewhere on the board

Notes on the sheet:
ic AP63203
Regulador 3.3V
