BRYANSFM/Bryan_Fernandez_ELECTIVA_2025_C2/zorionx_nivara/zorionx_nivara.kicad_pcb

## KiCad design zorionx_nivara/zorionx_nivara.kicad_pcb (continued)

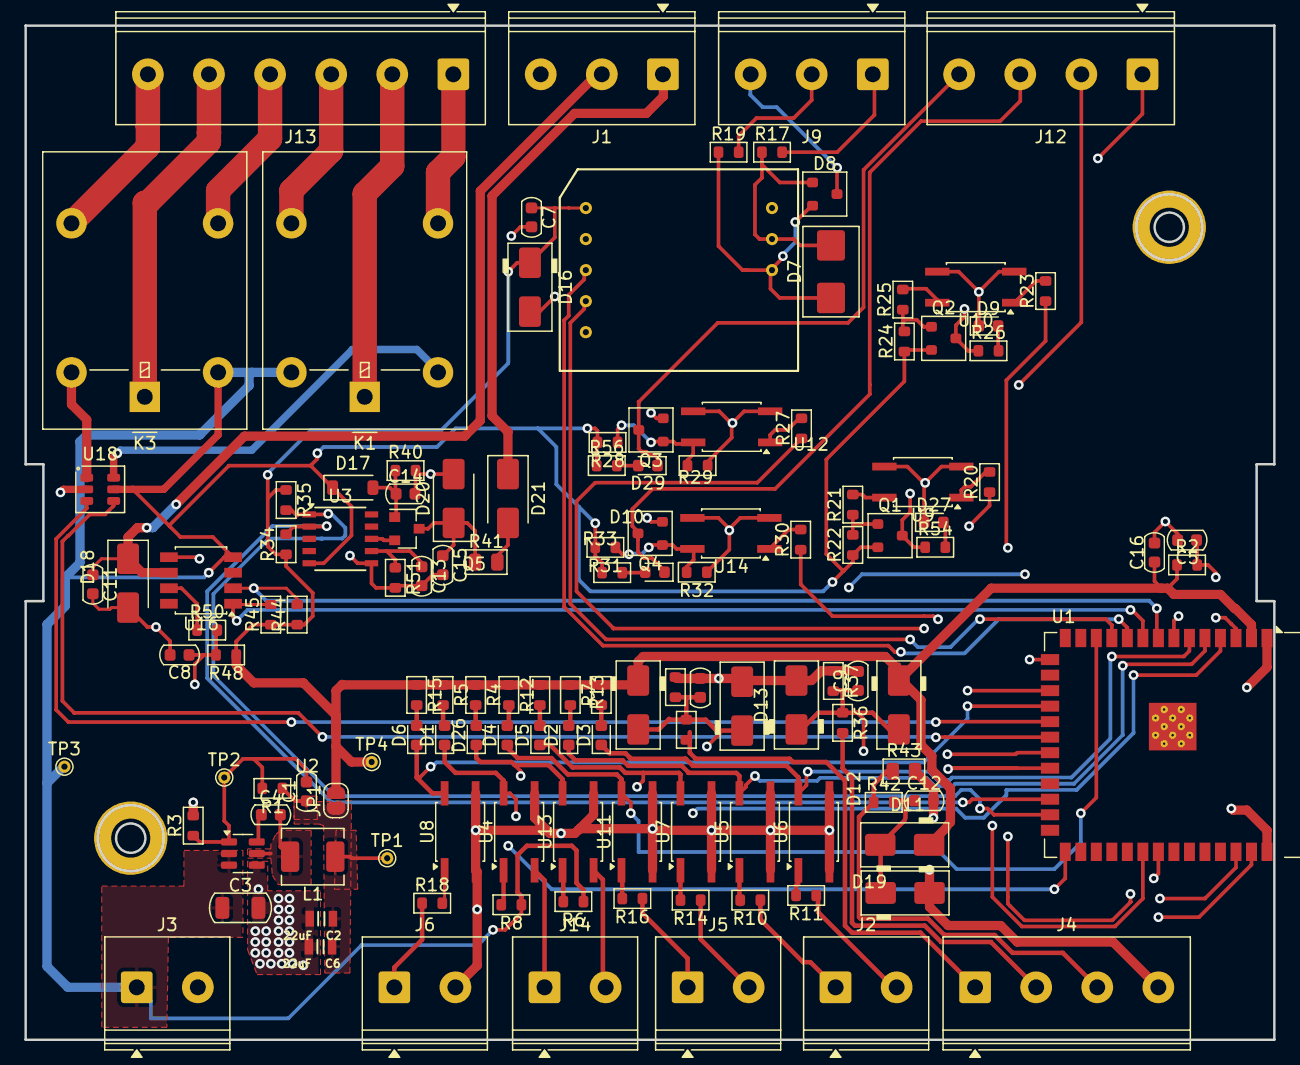
[picture p19: board zorionx_nivara.kicad_pcb from above]

Board: 4 copper layers, 102.2 x 83.0 mm, 132 parts (0 on the bottom side), 93 nets.
