BRYANSFM/Bryan_Fernandez_ELECTIVA_2025_C2/(commit log)

2025-07-11 Primer commit local
    [Driver_RS485.kicad_sch, Input_NPN.kicad_sch, Input_PNP.kicad_sch, Output_NPN.kicad_sch, Output_PNP.kicad_sch, PowerSupply.kicad_sch, board_zorionx-nivara.kicad_sch, zorionx_nivara.kicad_pcb]
2025-07-11 Primer commit
    [CajaElectiva_para_PCB.dxf, Caja_Electiva.FCStd, Caja_Parte_de_Arriba_Electiva.FCStd, Caja_Parte_de_Arriba_Electiva.dxf, Driver_RS485.kicad_sch, Input_NPN.kicad_sch, Input_PNP.kicad_sch, Output_NPN.kicad_sch]
2025-07-11 Primer commit 2
    [Caja_Electiva.FCStd, Caja_Parte_de_Arriba_Electiva.FCStd, Driver_RS485.kicad_sch, Input_NPN.kicad_sch, Input_PNP.kicad_sch, Output_NPN.kicad_sch, Output_PNP.kicad_sch, PCB_Electiva.kicad_pcb]
2025-07-16 ultimo commit 1
    [ANALOG_IN.kicad_sch, DIGITAL_IN.kicad_sch, Driver_RS485.kicad_sch, Input_NPN.kicad_sch, Output_NPN.kicad_sch, PowerSupply.kicad_sch, board_zorionx-nivara.kicad_sch, zorionx_nivara.kicad_sch]
